vigneshjathavara/GestureRecognition/README.md

# GestureRecognition
A gesture recognition device using Arduino101 and flex sensors 

The complete Arduino Code is located at GestureRecognition/ArduinoCode/Mime.ino
