vigneshjathavara/GestureRecognition/(commit log)

2016-11-12 Incorporated OS X IOKit - Now cursor is controllable by device on OS X
2016-11-15 Update A101_IndividualResearch.ino
    Incorporated flex sensor for clicks
    [A101_IndividualResearch.ino]
